hiiamfrompoland/eyes/Solids/eye_holster1.SLDPRT

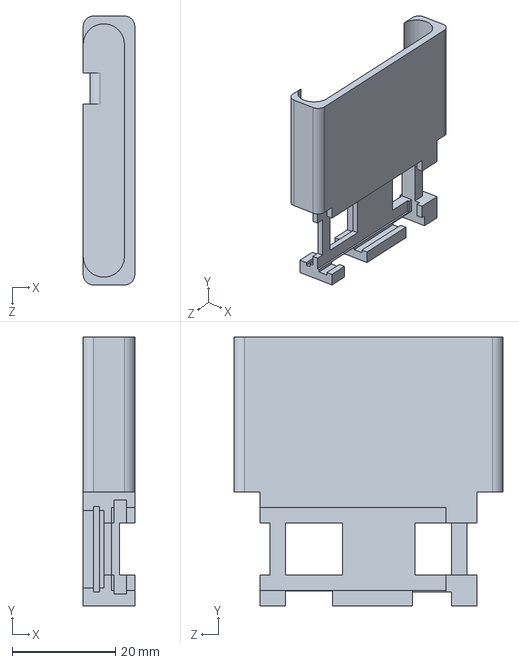
[picture p1: CAD file, 2017-04-30]
Solids/eye_holster1.SLDPRT
10.0 x 52.0 x 52.0 mm
