hiiamfrompoland/eyes/PCB/ppm.kicad_pcb

## KiCad design PCB/ppm.kicad_pcb (2017-04-21)

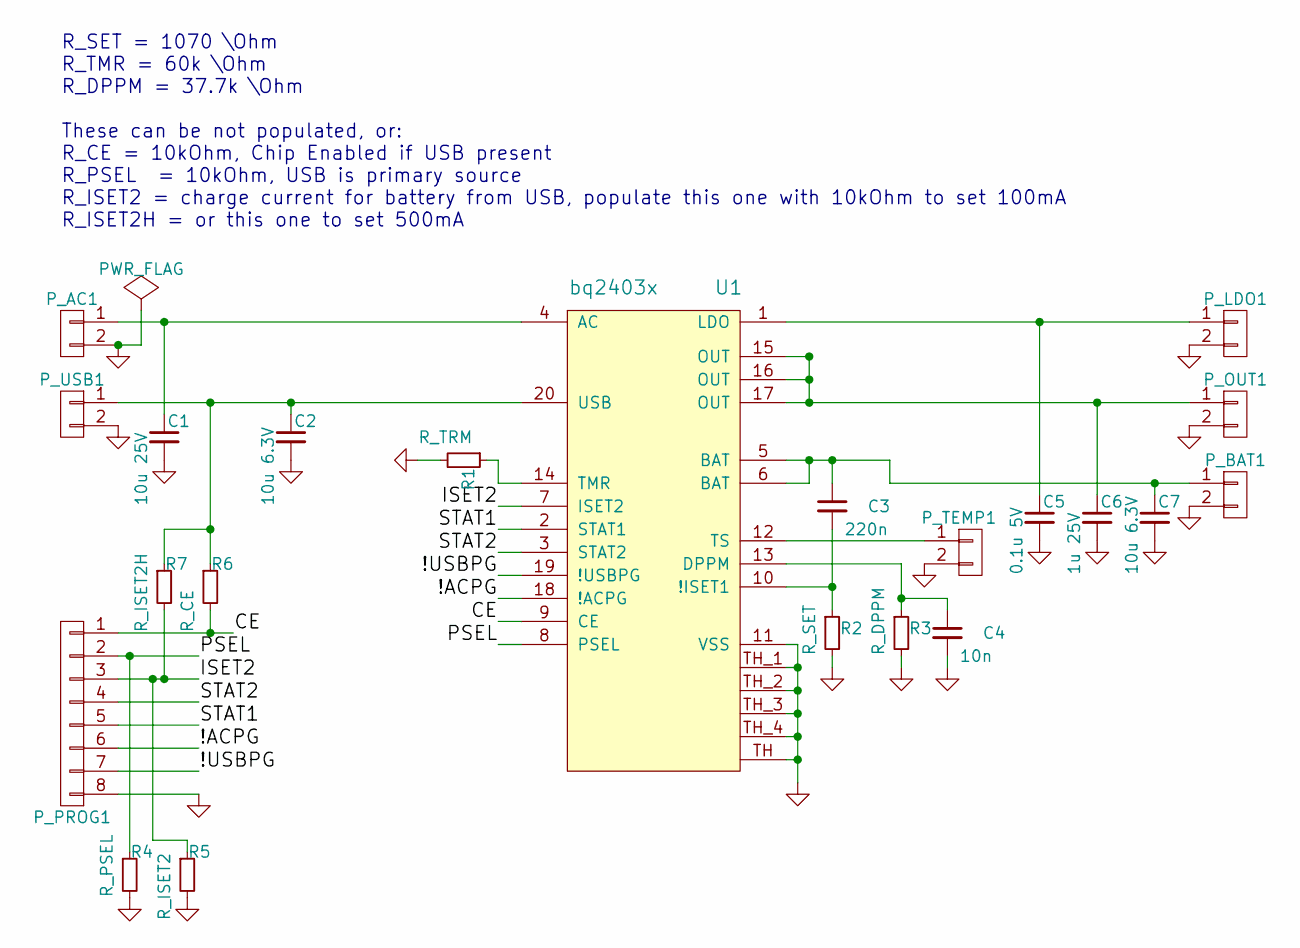
[picture p2: schematic ppm.sch, BQ24032 breakout]

Parts:
C1: 10u 25V; C_0603
C2, C7: 10u 6.3V; C_0603
C3: 220n; C_0603
C4: 10n; C_0603
C5: 0.1u 5V; C_0603
C6: 1u 25V; C_0603
P_AC1: CONN_01X02; PINHEAD2_1.27
P_BAT1: CONN_01X02; PINHEAD2_1.27
P_LDO1: CONN_01X02; PINHEAD2_1.27
P_OUT1: CONN_01X02; PINHEAD2_1.27
P_PROG1: CONN_01X08; PINHEAD8_1.27
P_TEMP1: CONN_01X02; PINHEAD2_1.27
P_USB1: CONN_01X02; PINHEAD2_1.27
R1: R_TRM; R_0603
R2: R_SET; R_0603
R3: R_DPPM; R_0603
R4: R_PSEL; R_0603
R5: R_ISET2; R_0603
R6: R_CE; R_0603
R7: R_ISET2H; R_0603
U1: bq2403x; PVQFN-N20

Connections:
/!ACPG: P_PROG1.6, U1.18 (!ACPG)
/!USBPG: P_PROG1.7, U1.19 (!USBPG)
/CE: P_PROG1.1, R6.2, U1.9 (CE)
/ISET2: P_PROG1.3, R5.1, R7.2, U1.7 (ISET2)
/PSEL: P_PROG1.2, R4.1, U1.8 (PSEL)
/STAT1: P_PROG1.5, U1.2 (STAT1)
/STAT2: P_PROG1.4, U1.3 (STAT2)
GND: C1.2, C2.2, C4.2, C5.2, C6.2, C7.2, P_AC1.2, P_BAT1.2, P_LDO1.2, P_OUT1.2, P_PROG1.8, P_TEMP1.2, P_USB1.2, R1.2, R2.2, R3.2, R4.2, R5.2, U1.11 (VSS), U1.TH, U1.TH_1, U1.TH_2, U1.TH_3, U1.TH_4
unnamed: C1.1, P_AC1.1, U1.4 (AC)
unnamed: C2.1, P_USB1.1, R6.1, R7.1, U1.20 (USB)
unnamed: C3.1, C7.1, P_BAT1.1, U1.5 (BAT), U1.6 (BAT)
unnamed: C3.2, R2.1, U1.10 (!ISET1)
unnamed: C4.1, R3.1, U1.13 (DPPM)
unnamed: C5.1, P_LDO1.1, U1.1 (LDO)
unnamed: C6.1, P_OUT1.1, U1.15 (OUT), U1.16 (OUT), U1.17 (OUT)
unnamed: P_TEMP1.1, U1.12 (TS)
unnamed: R1.1, U1.14 (TMR)

Notes on the sheet:
R_SET = 1070 \Ohm R_TMR = 60k \Ohm R_DPPM = 37.7k \Ohm These can be not populated, or: R_CE = 10kOhm, Chip Enabled if USB present R_PSEL = 10kOhm, USB is primary source R_ISET2 = charge current for battery from USB, populate this one with 10kOhm to set 100mA R_ISET2H = or this one to set 500mA

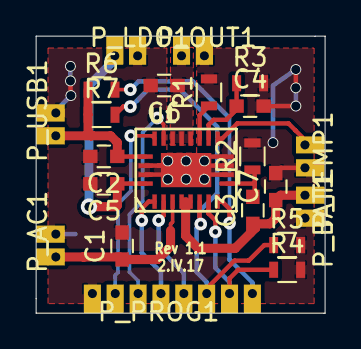
[picture p3: board ppm.kicad_pcb from above]

Board: 2 copper layers, 16.1 x 15.4 mm, 22 parts (0 on the bottom side), 17 nets.
