hiiamfrompoland/eyes/(commit log)

2017-04-11 Created repo
    [ppm-B.Cu.gbr, ppm-B.Mask.gbr, ppm-Edge.Cuts.gbr, ppm-F.Cu.gbr, ppm-F.Mask.gbr, ppm-F.SilkS.gbr, ppm-drl_map.gbr, ppm.drl]
2017-04-21 PCB fix, Docs updated, more quaternions
    [ppm.kicad_pcb]
2017-04-28 Cleaning up code a bit
    [ppm-B.Cu.gbr, ppm-B.Mask.gbr, ppm-Edge.Cuts.gbr, ppm-F.Cu.gbr, ppm-F.Mask.gbr, ppm-F.SilkS.gbr, ppm-drl_map.gbr, ppm.drl]
2017-04-28 Added button functionality to code, but no button in place :(
2017-04-30 Added 3d model for printing
    [eye_holster1.SLDPRT]
